MBilalQ/Quadcopter-Control/(commit log)

2025-04-12 Changes for testing two motors
2025-04-12 added arming to start motors properly
2025-04-12 Arming added to start motors properly
2025-04-13 adjusted the values of pwm accordingly for both motors
2025-04-16 Tuned RPM of right motor
2025-04-17 Tuned PID
2025-04-17 Tuned pwm values
